thatismail1/EE463-Hardware-Project/Plots/3p_output_A.jpg

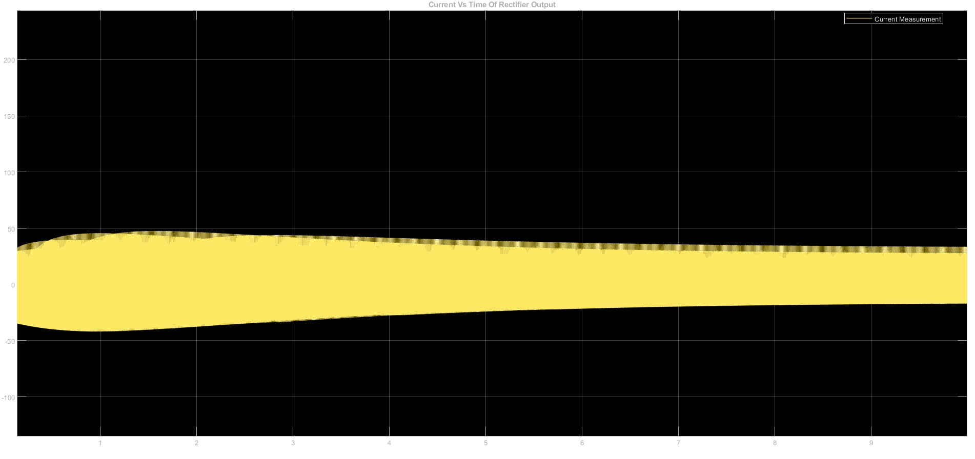
Plots/3p_output_A.jpg
