thatismail1/EE463-Hardware-Project/Plots/3p_output_A_detailed.jpg

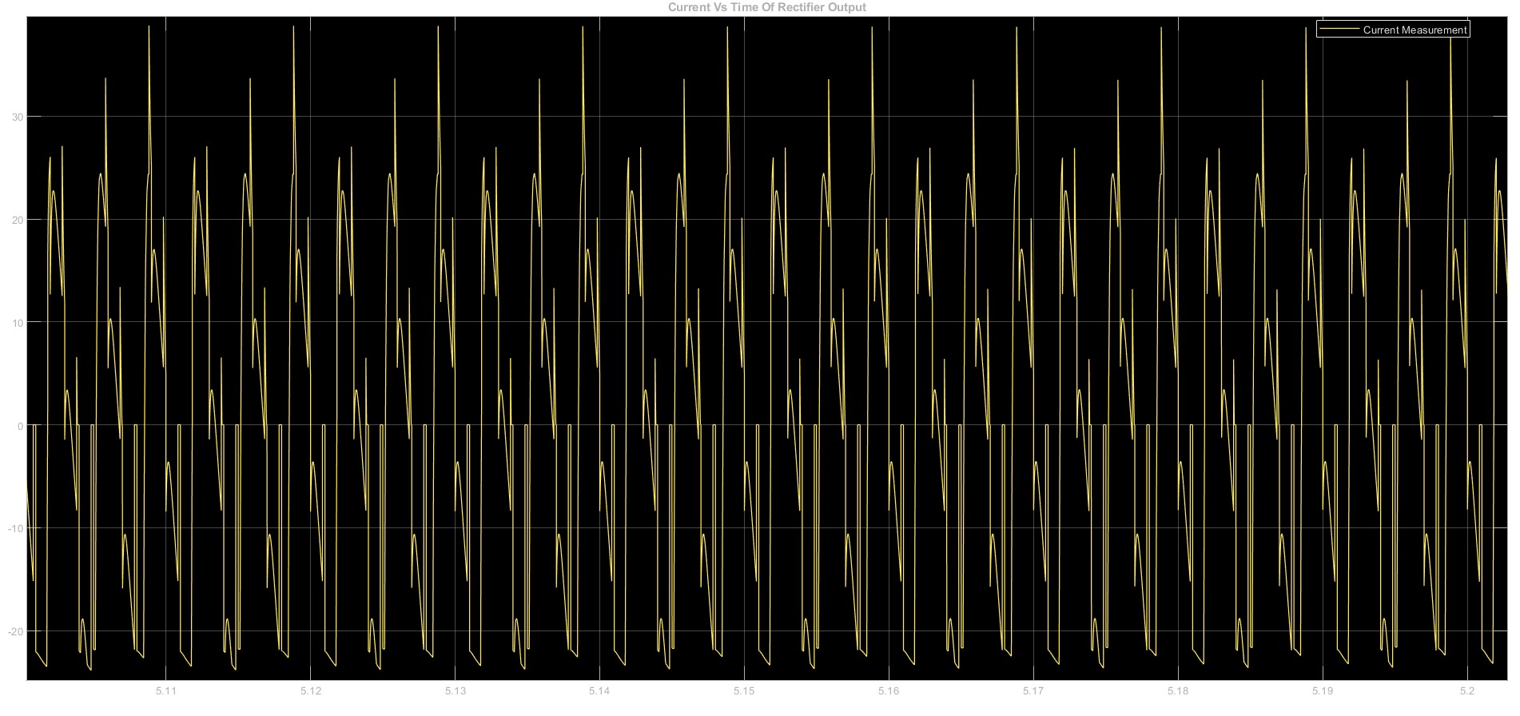
Plots/3p_output_A_detailed.jpg
