thatismail1/EE463-Hardware-Project/Plots/3p_output_V.jpg

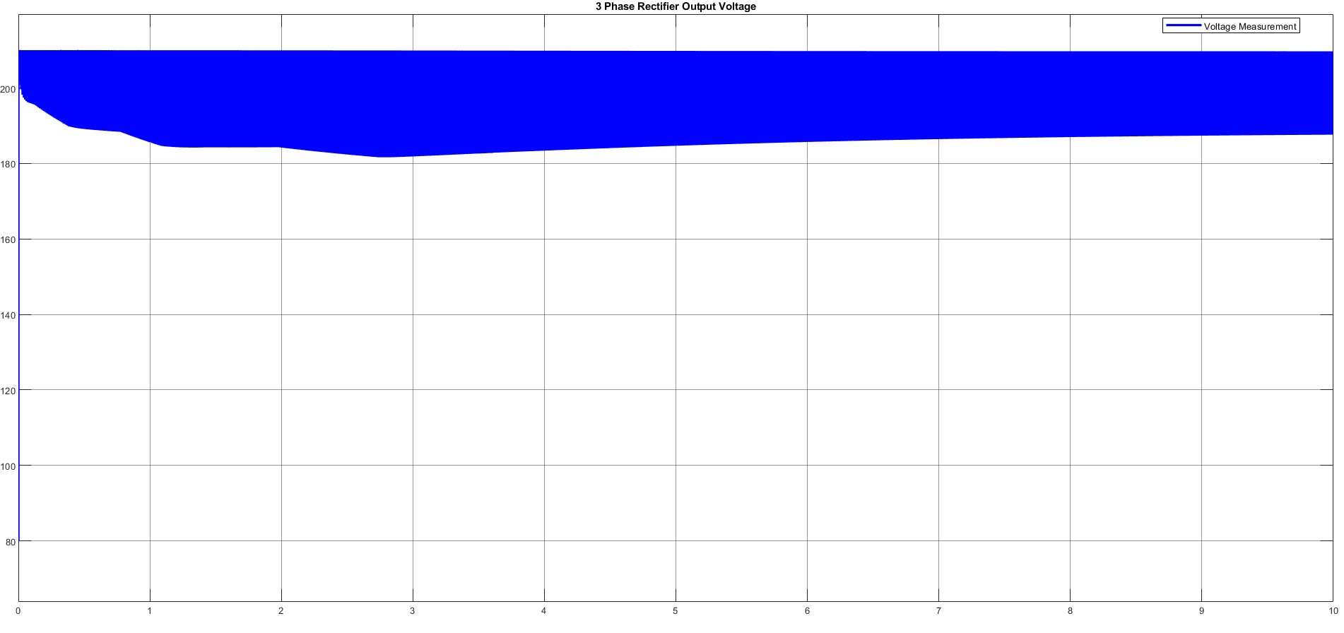
Plots/3p_output_V.jpg
