thatismail1/EE463-Hardware-Project/Plots/3p_output_V_detailed.jpg

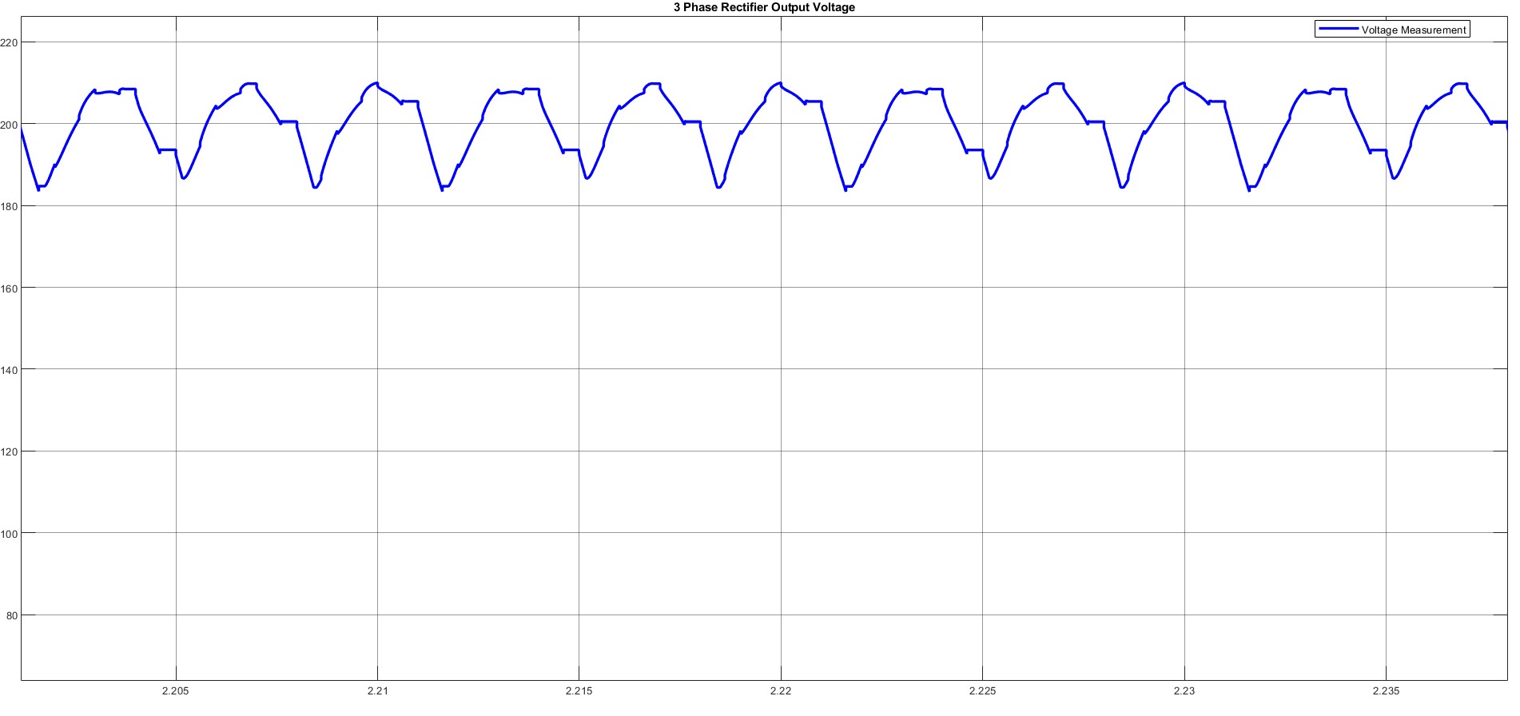
Plots/3p_output_V_detailed.jpg
