thatismail1/EE463-Hardware-Project/Plots/3p_rectifier.jpg

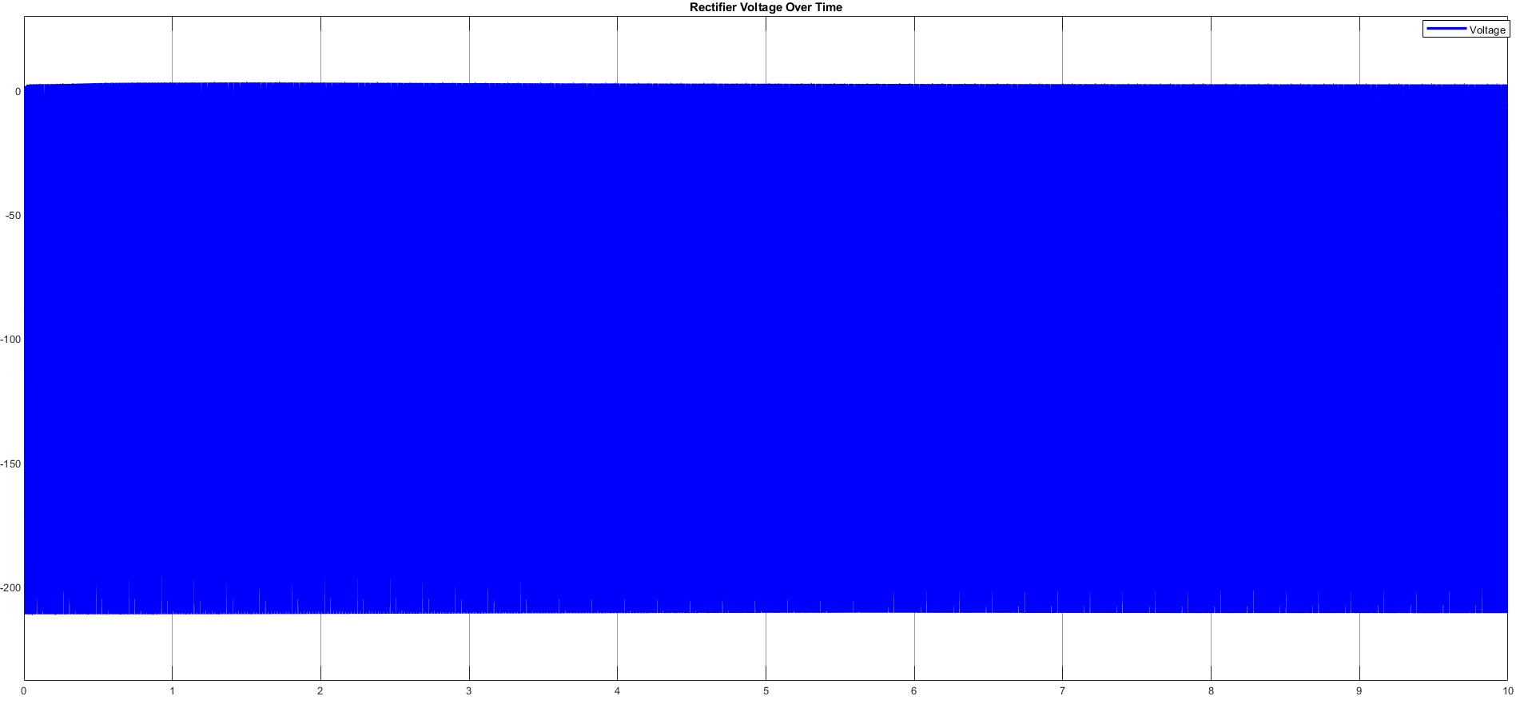
Plots/3p_rectifier.jpg
