thatismail1/EE463-Hardware-Project/Plots/3p_rectifier_detailed_A.jpg

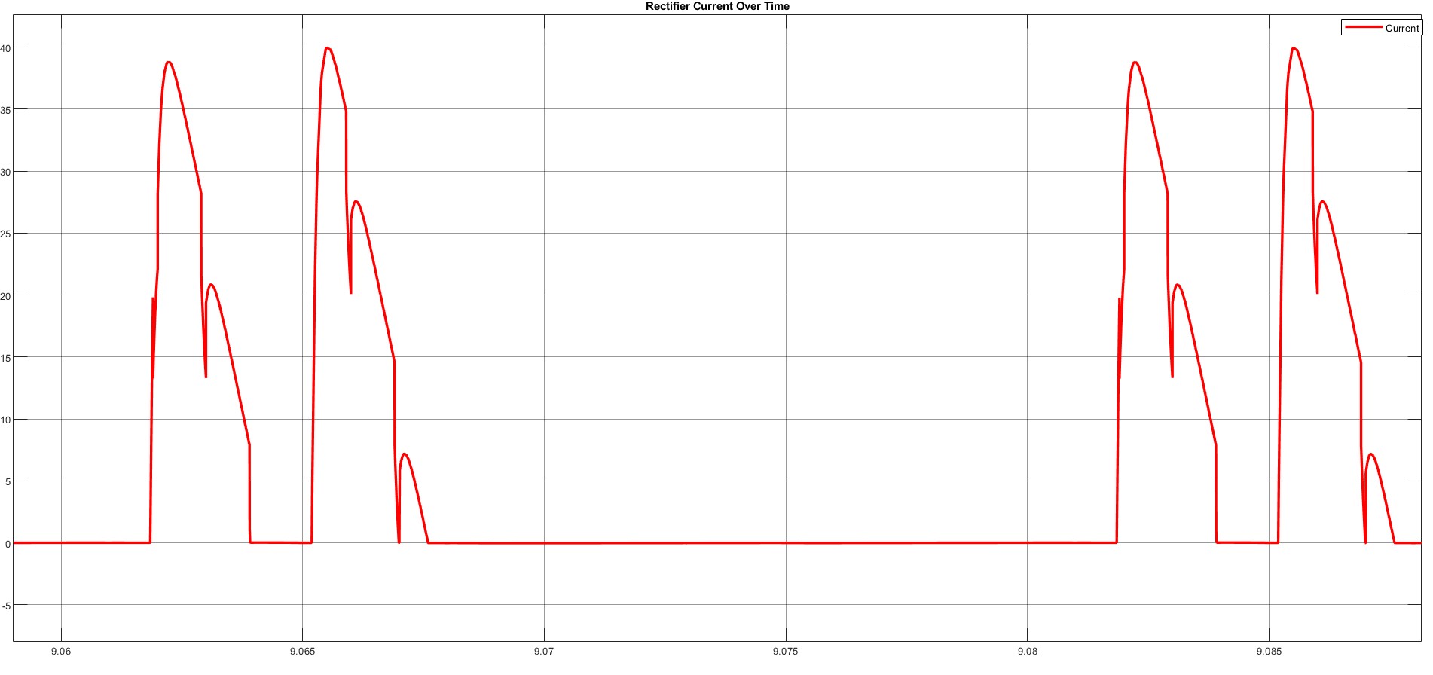
Plots/3p_rectifier_detailed_A.jpg
