thatismail1/EE463-Hardware-Project/Plots/Freediode_A.jpg

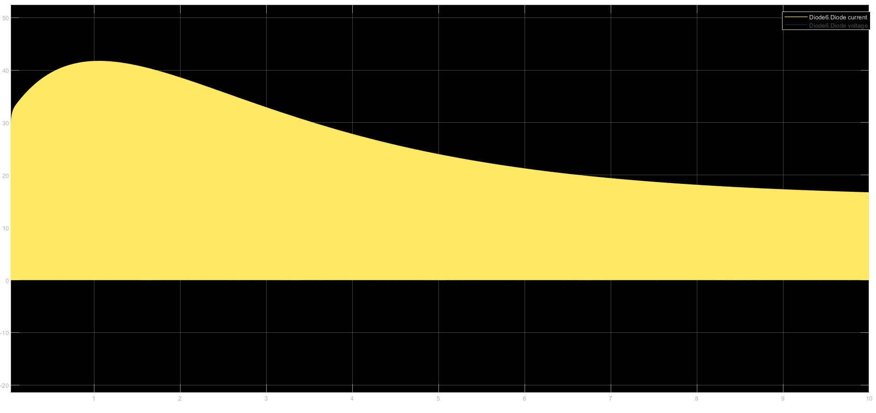
Plots/Freediode_A.jpg
