thatismail1/EE463-Hardware-Project/Plots/Freediode_A_detailed.jpg

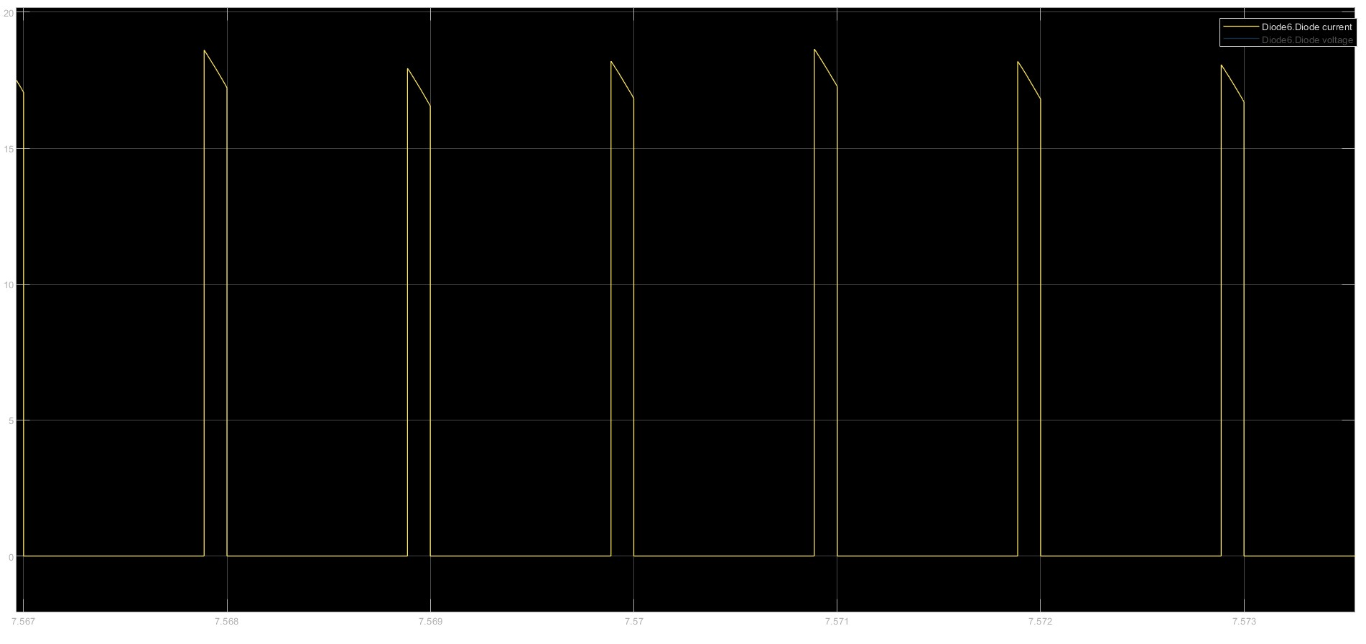
Plots/Freediode_A_detailed.jpg
