thatismail1/EE463-Hardware-Project/Plots/Freediode_V.jpg

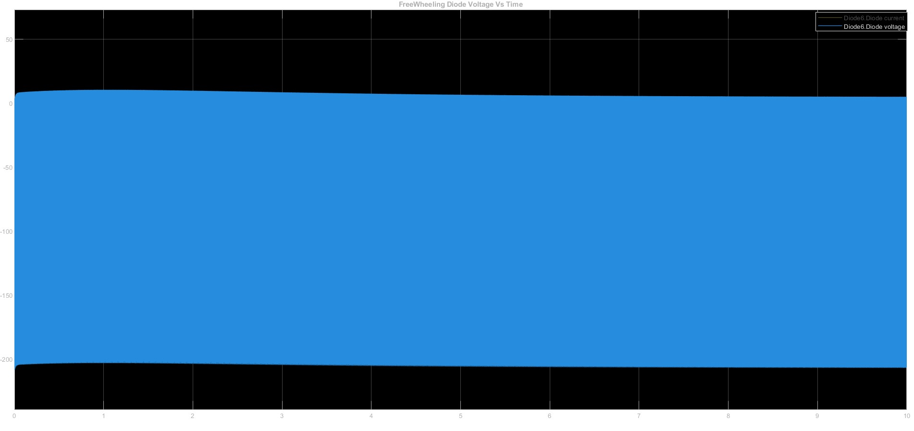
Plots/Freediode_V.jpg
