thatismail1/EE463-Hardware-Project/Plots/Freediode_V_detailed.jpg

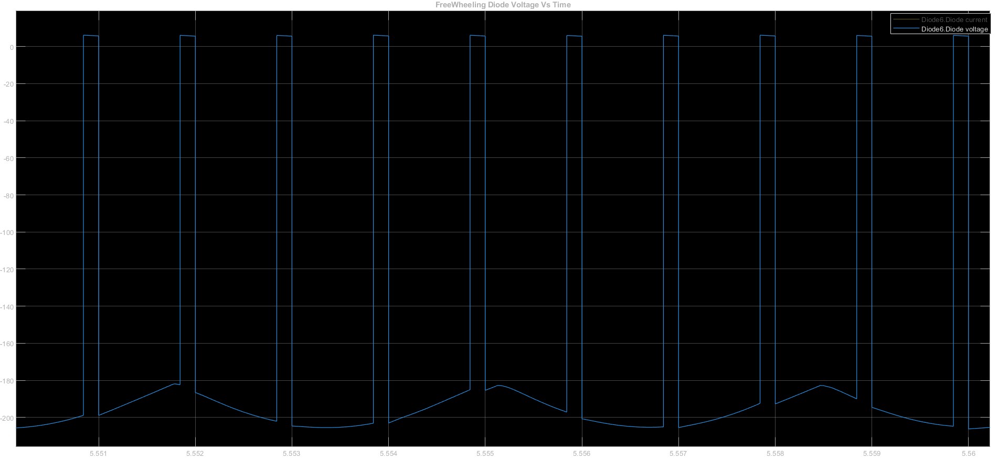
Plots/Freediode_V_detailed.jpg
