thatismail1/EE463-Hardware-Project/Plots/mosfet_a.jpg

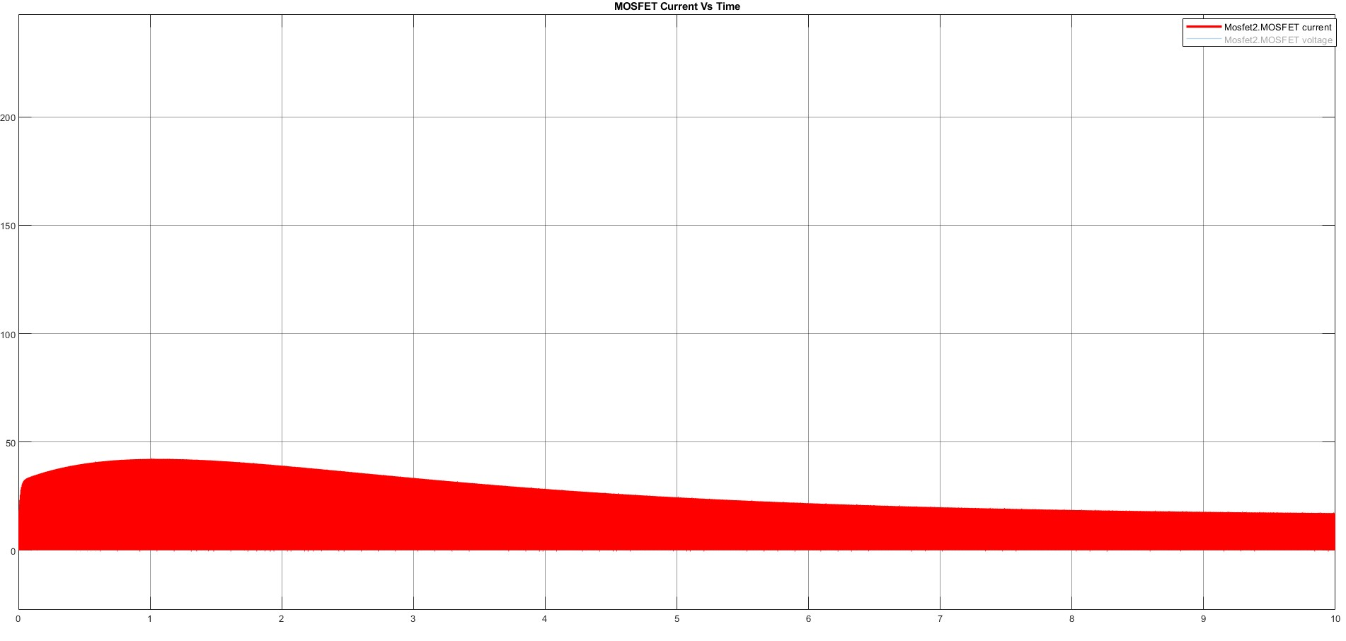
Plots/mosfet_a.jpg
