thatismail1/EE463-Hardware-Project/Plots/mosfet_a_detailed.jpg

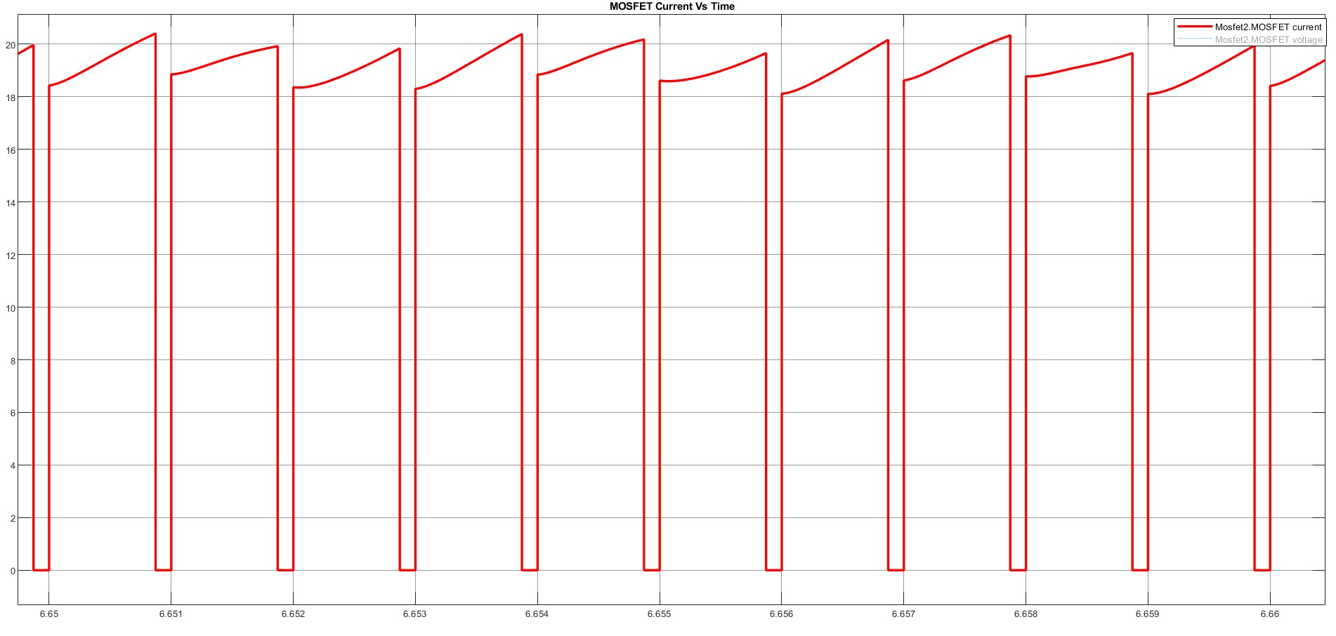
Plots/mosfet_a_detailed.jpg
