thatismail1/EE463-Hardware-Project/Plots/mosfet_v.jpg

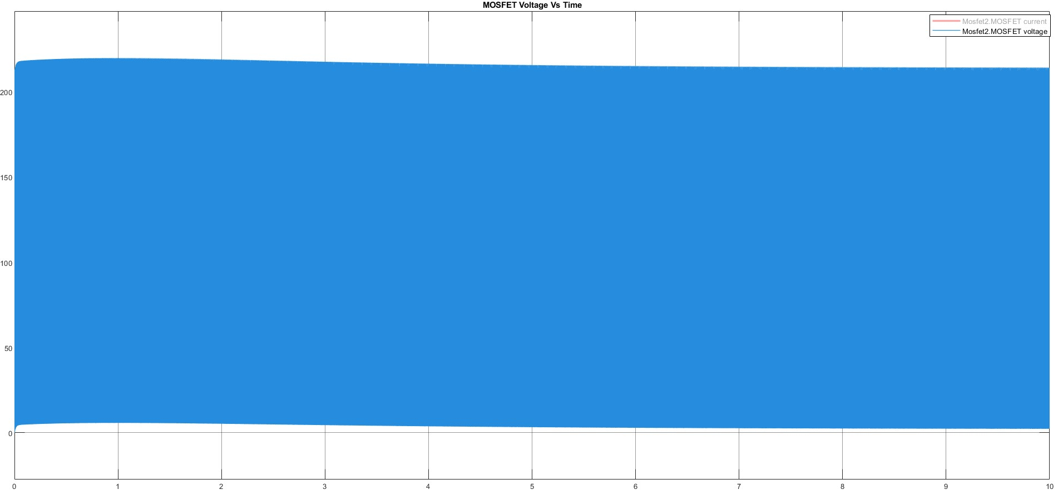
Plots/mosfet_v.jpg
