thatismail1/EE463-Hardware-Project/Plots/mosfet_v_detailed.jpg

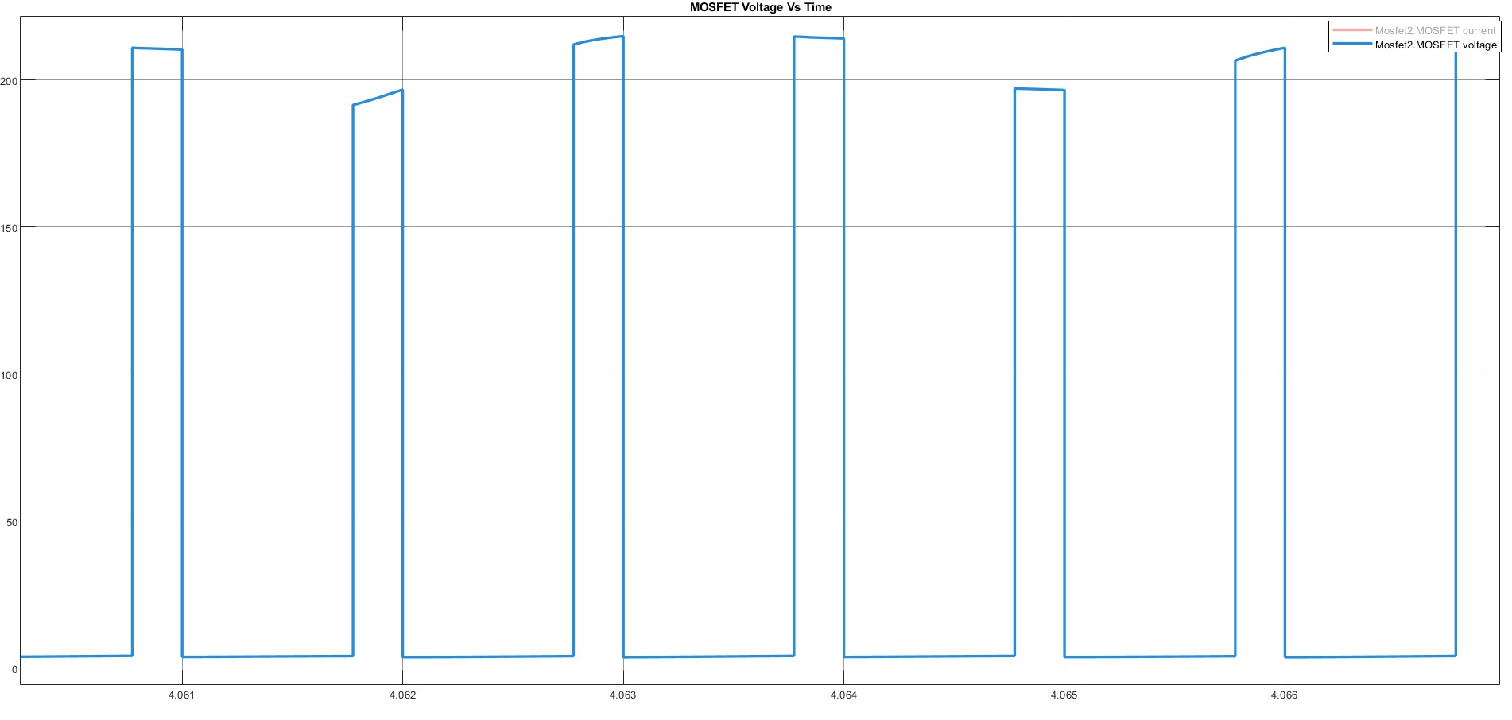
Plots/mosfet_v_detailed.jpg
