thatismail1/EE463-Hardware-Project/Plots/output A.jpg

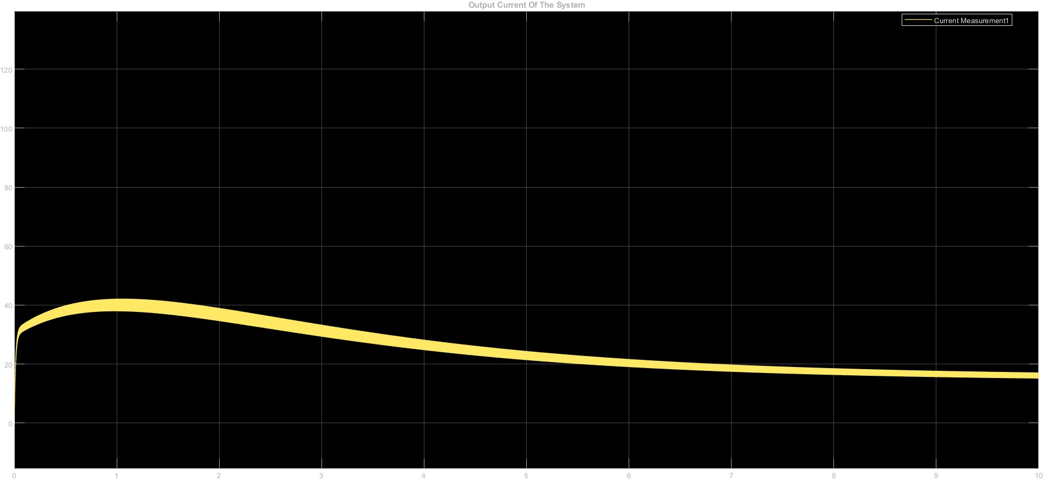
Plots/output A.jpg
