thatismail1/EE463-Hardware-Project/Plots/output A_d.jpg

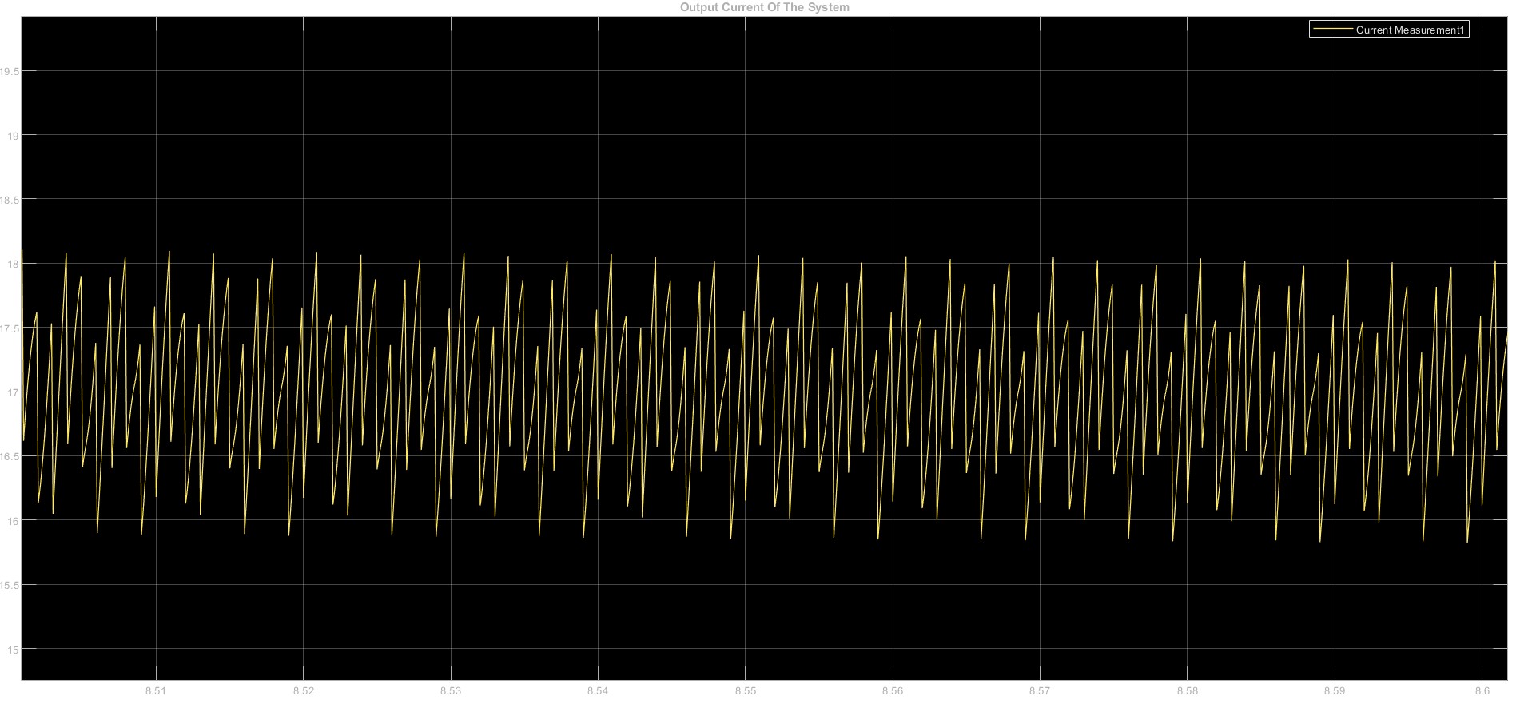
Plots/output A_d.jpg
