thatismail1/EE463-Hardware-Project/Plots/output voltage_d.jpg

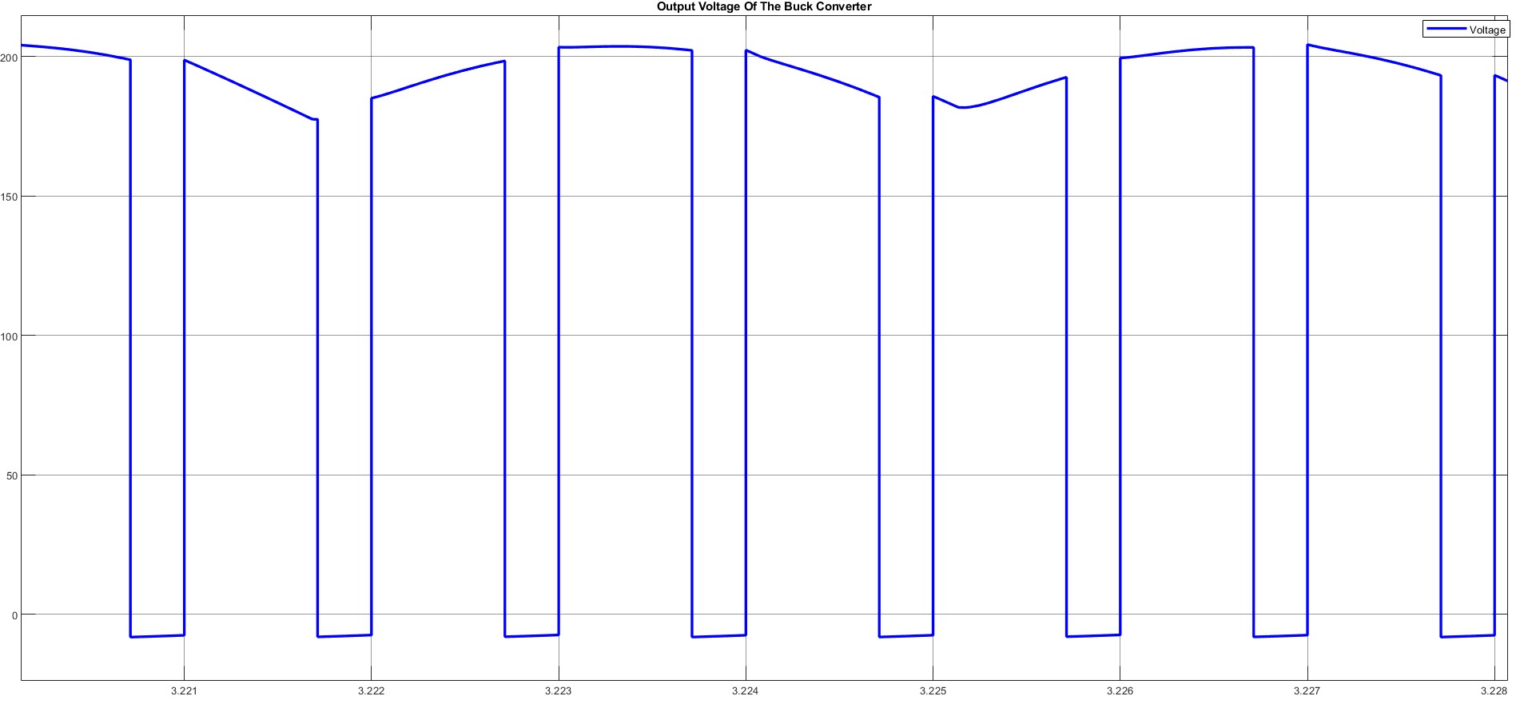
Plots/output voltage_d.jpg
