thatismail1/EE463-Hardware-Project/Plots/speed.jpg

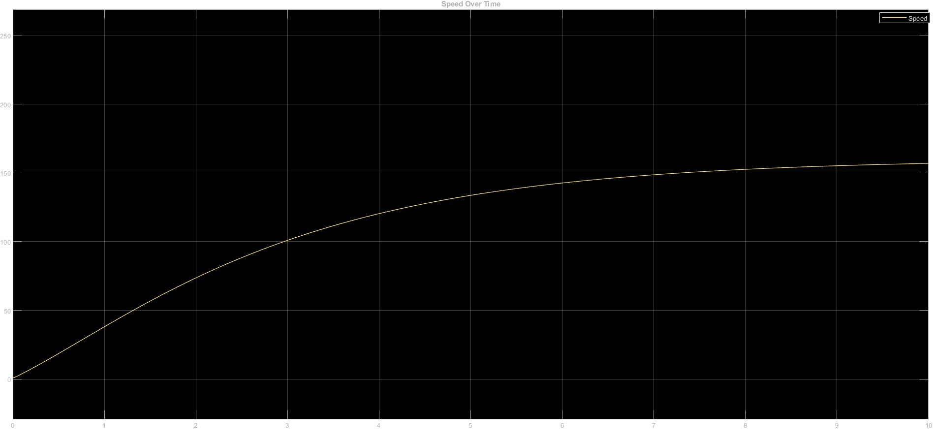
Plots/speed.jpg
