thatismail1/EE463-Hardware-Project/EE463/EE463.kicad_pcb

## KiCad design EE463/EE463.kicad_pcb (2025-01-20)

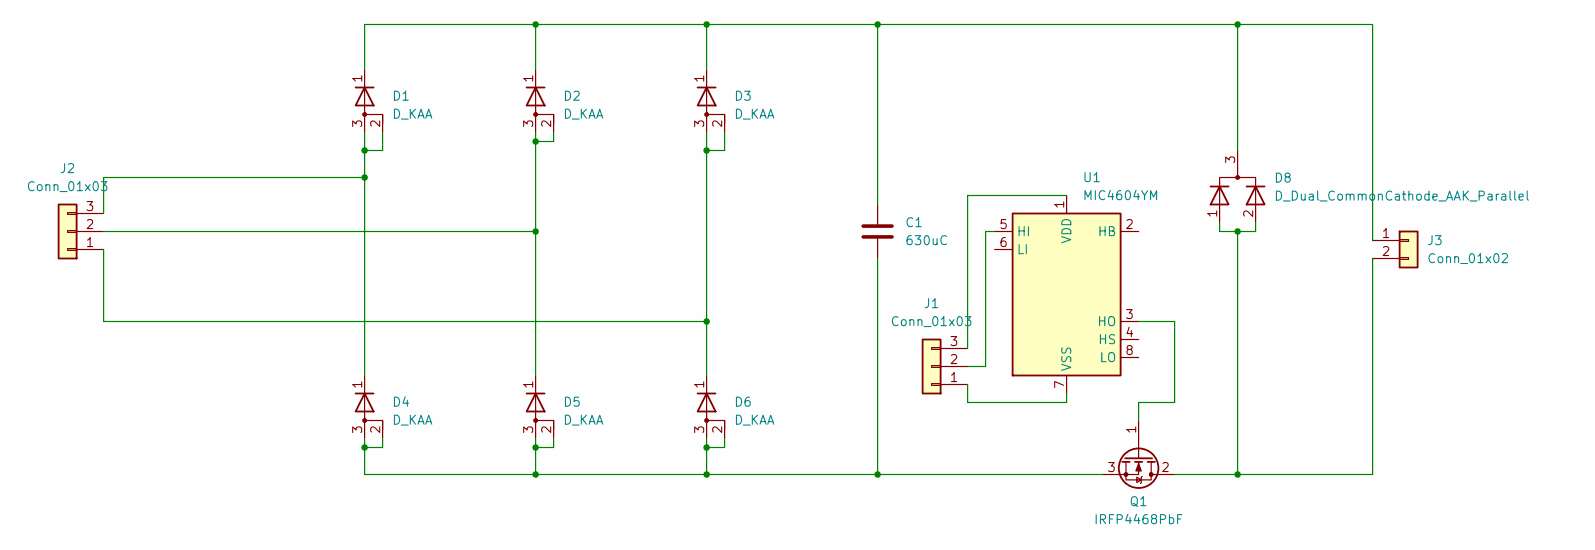
[picture p70: schematic EE463.kicad_sch]

Parts:
C1: 630uC; CP_Radial_D24.0mm_P10.00mm_SnapIn
D1, D2, D3, D4, D5, D6: D_KAA; TO-247-3_Vertical
D8: D_Dual_CommonCathode_AAK_Parallel; TO-247-3_Vertical
J1, J2: Conn_01x03; PhoenixContact_MC_1,5_3-G-5.08_1x03_P5.08mm_Horizontal
J3: Conn_01x02; PhoenixContact_MC_1,5_2-G-3.5_1x02_P3.50mm_Horizontal
Q1: IRFP4468PbF; TO-247-3_Vertical
U1: MIC4604YM; SOIC-8_3.9x4.9mm_P1.27mm

Connections:
unnamed: C1.1, D1.1 (K), D2.1 (K), D3.1 (K), D8.3 (K), J3.1
unnamed: D1.2 (A), D1.3 (A), D4.1 (K), J2.3
unnamed: D2.2 (A), D2.3 (A), D5.1 (K), J2.2
unnamed: D3.2 (A), D3.3 (A), D6.1 (K), J2.1
unnamed: J1.1, U1.7 (VSS)
unnamed: J1.2, U1.5 (HI)
unnamed: J1.3, U1.1 (VDD)
unnamed: D8.1 (A), D8.2 (A), J3.2, Q1.2 (D)
unnamed: Q1.1 (G), U1.3 (HO)
unnamed: C1.2, D4.2 (A), D4.3 (A), D5.2 (A), D5.3 (A), D6.2 (A), D6.3 (A), Q1.3 (S)

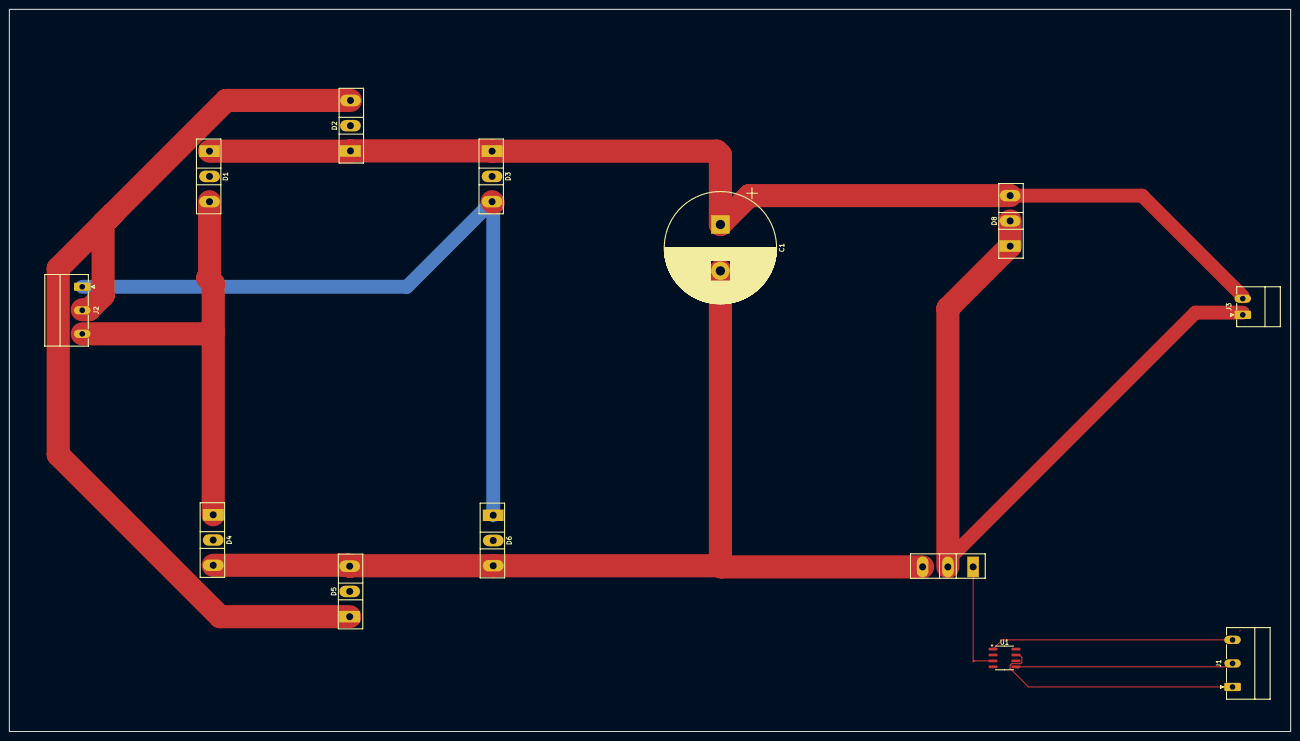
[picture p71: board EE463.kicad_pcb from above]

Board: 8 copper layers, 276.6 x 155.9 mm, 13 parts (0 on the bottom side), 10 nets.
