thatismail1/EE463-Hardware-Project/(commit log)

2024-11-17 simulink diagram of the project
    I tried to build a simulink model of three phase rectifier + buck converter + dc machine
2025-01-20 Gate driver
2025-01-20 Added Heatsink
2025-01-20 KiCad Files
    [EE463.kicad_pcb, EE463.kicad_sch, EE463_v02.kicad_pcb, EE463_v02.kicad_sch]
